bertrik/dotflipper/README.md

# dotflipper
My Flip Dot controller, based on the PCA9865 i2c port expanders

CC BY-SA 4.0
