bertrik/dotflipper/PCB/dotflipperschematic.pdf

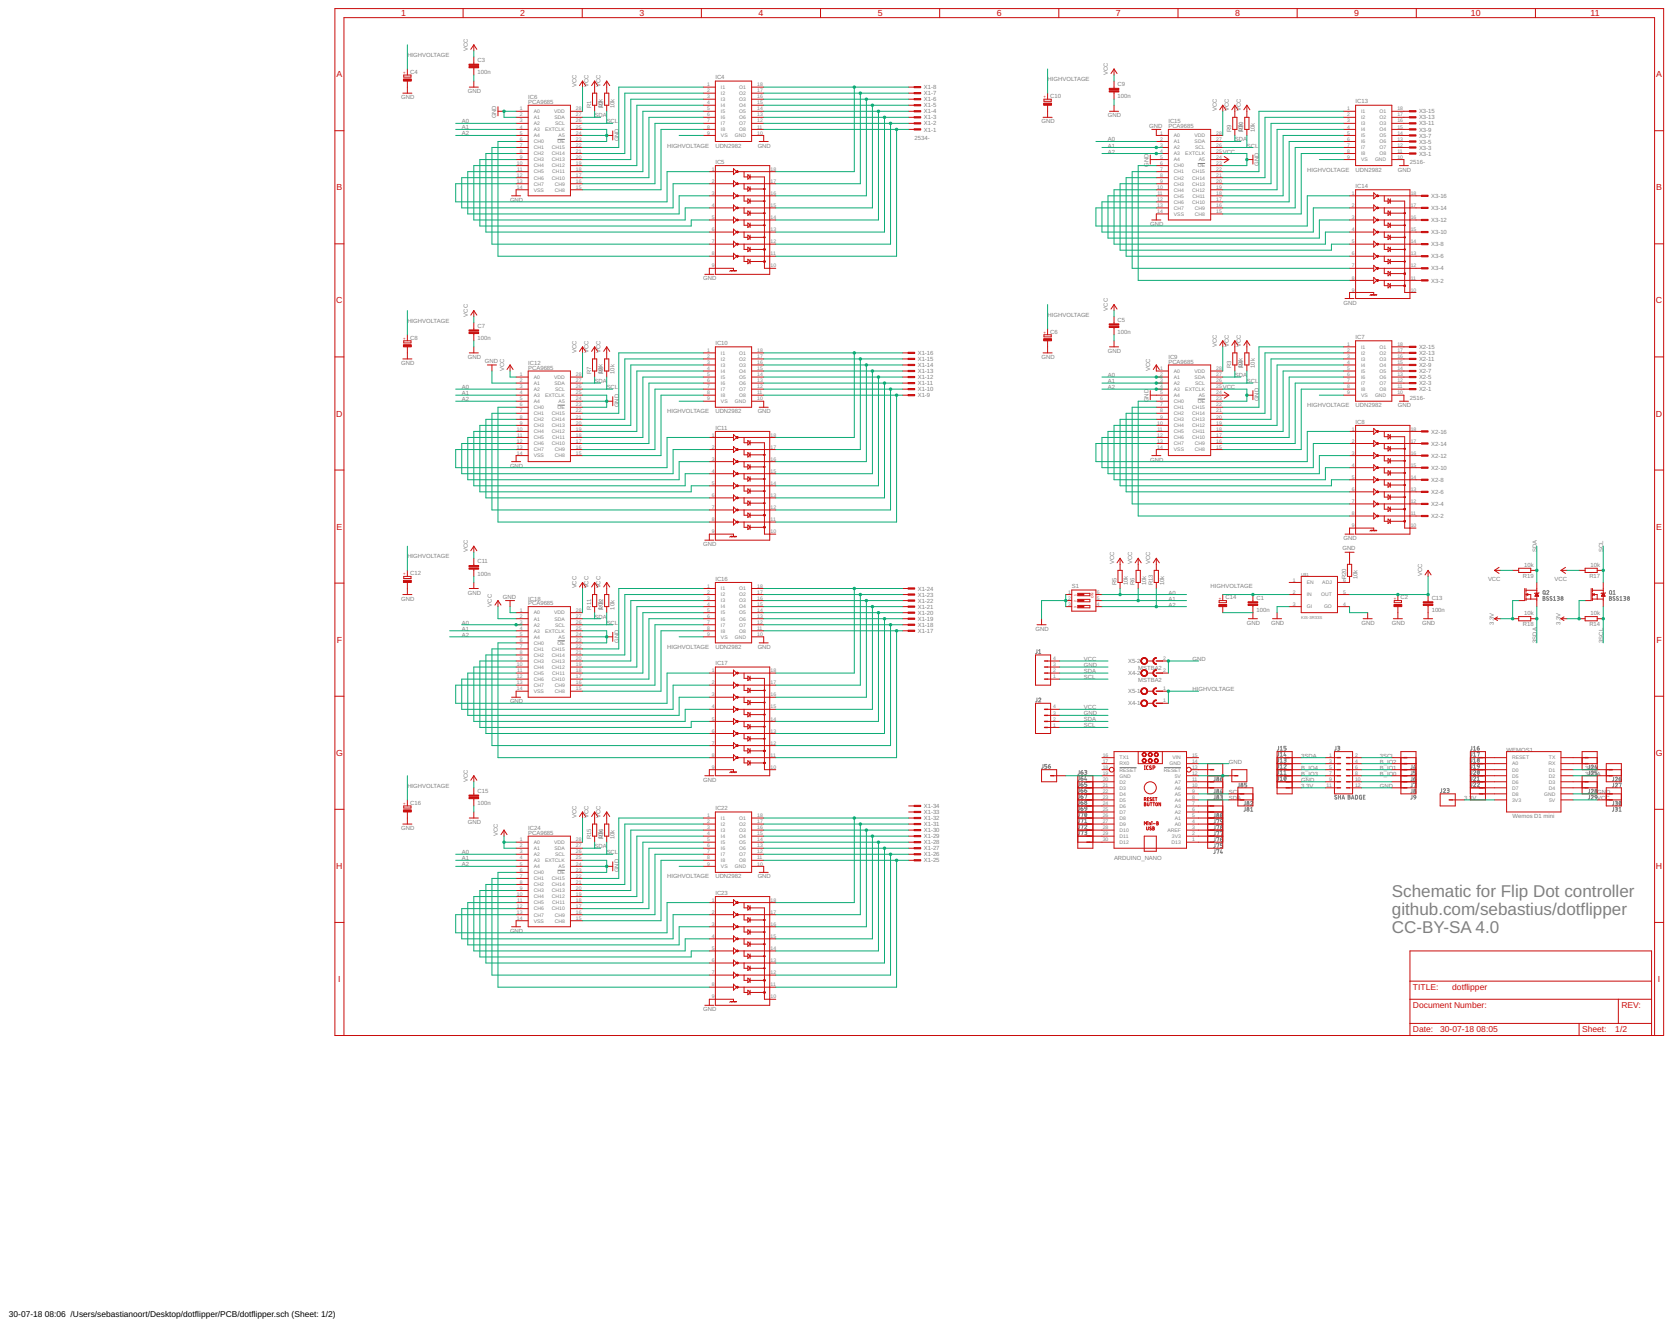
[picture p1: page 1]

CH2 8
CH3 9
CH4 10
CH5 11

Schematic for Flip Dot controller
github.com/sebastius/dotflipper

Document Number: | REV:

Date: 30-07-18 08:05 | Sheet: 1/2

30-07-18 08:06 /Users/sebastianoort/Desktop/dotflipper/PCB/dotflipper.sch (Sheet: 1/2)
