bertrik/dotflipper/PCB/dotflipperboard.pdf

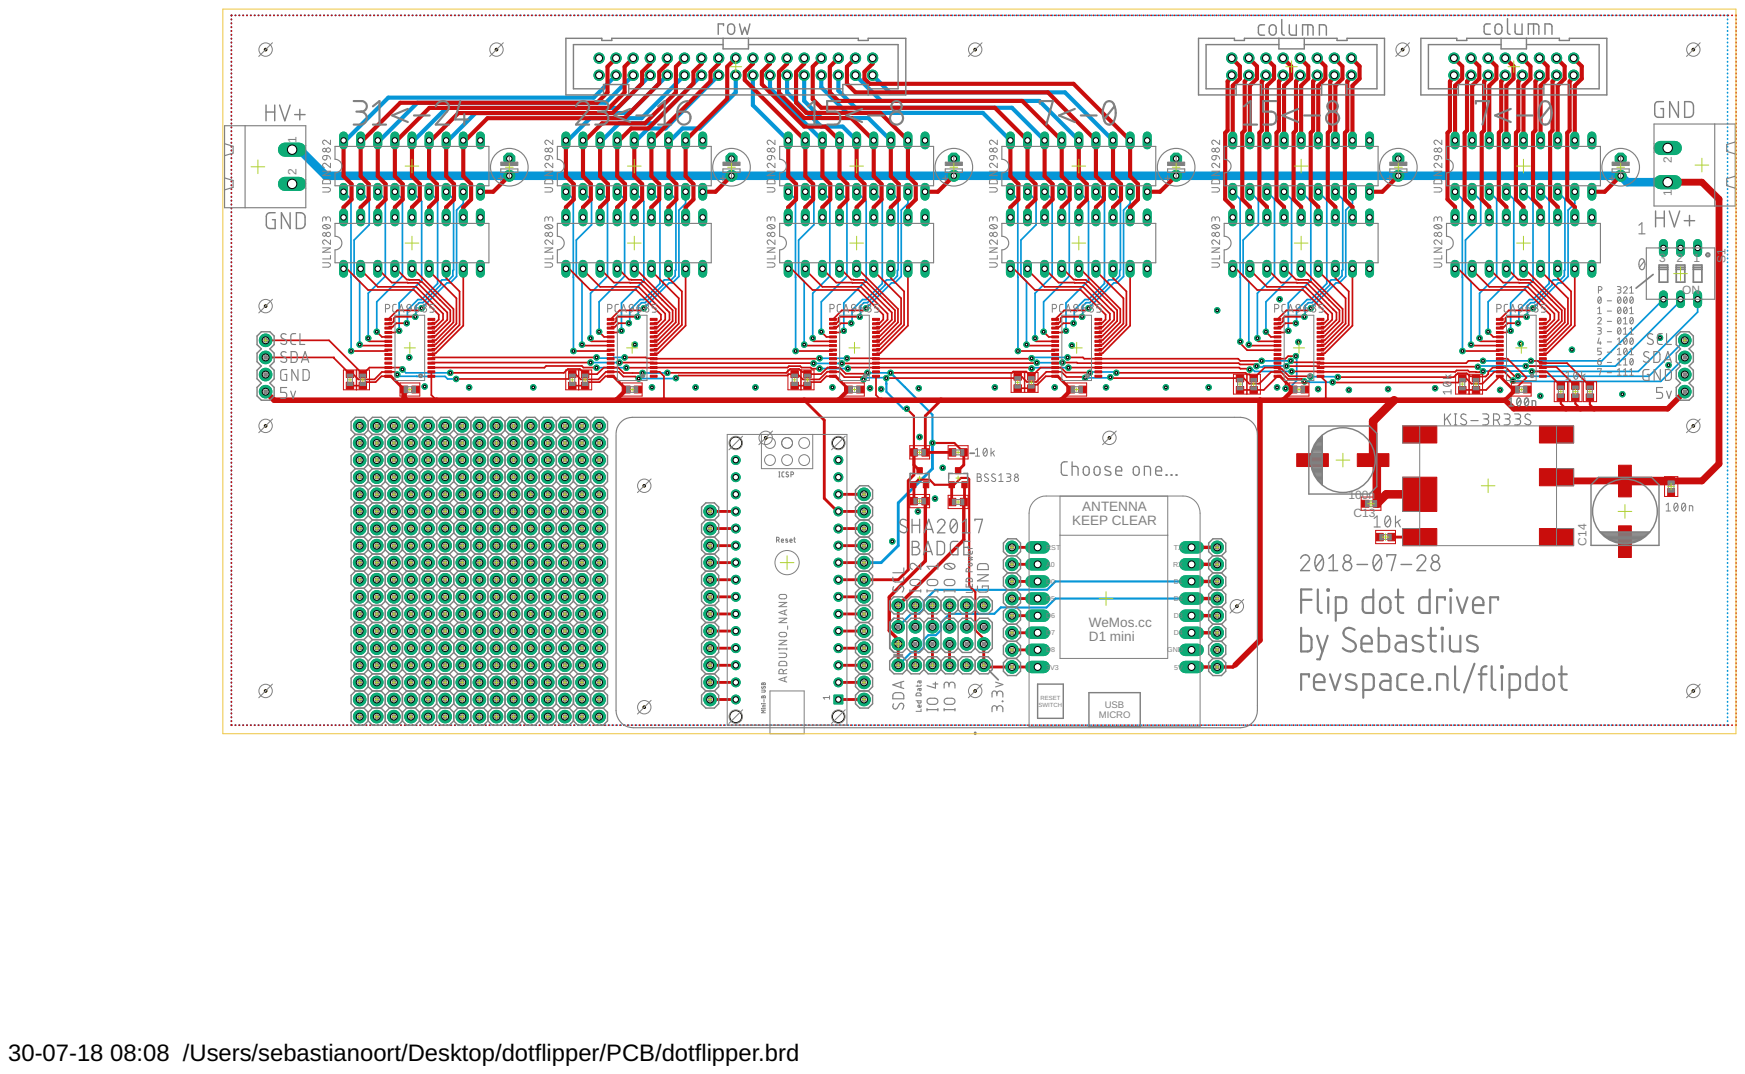
[picture p2: page 1]

30-07-18 08:08 /Users/sebastianoort/Desktop/dotflipper/PCB/dotflipper.brd
