bertrik/dotflipper/PCB/dotflippercomponents.pdf

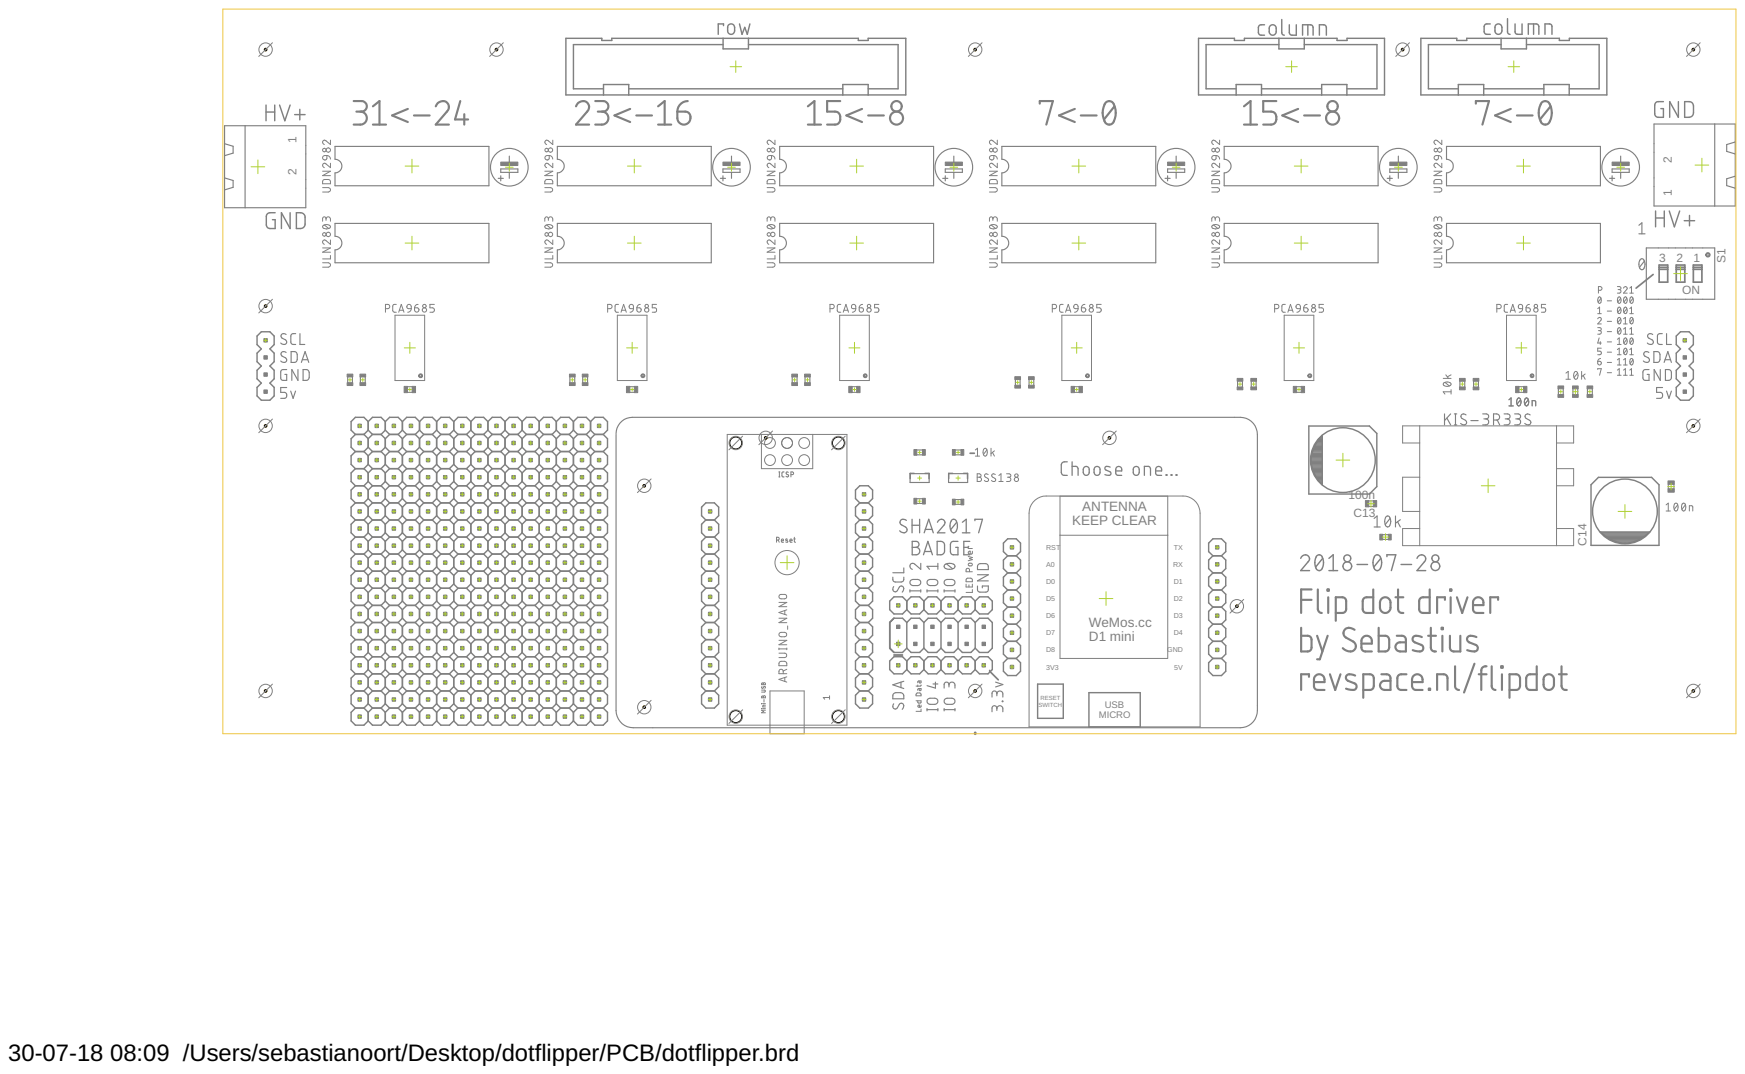
[picture p3: page 1]

30-07-18 08:09 /Users/sebastianoort/Desktop/dotflipper/PCB/dotflipper.brd
