bertrik/dotflipper/PCB/dotflipper.brd

## EAGLE design PCB/dotflipper.brd (2018-07-30)

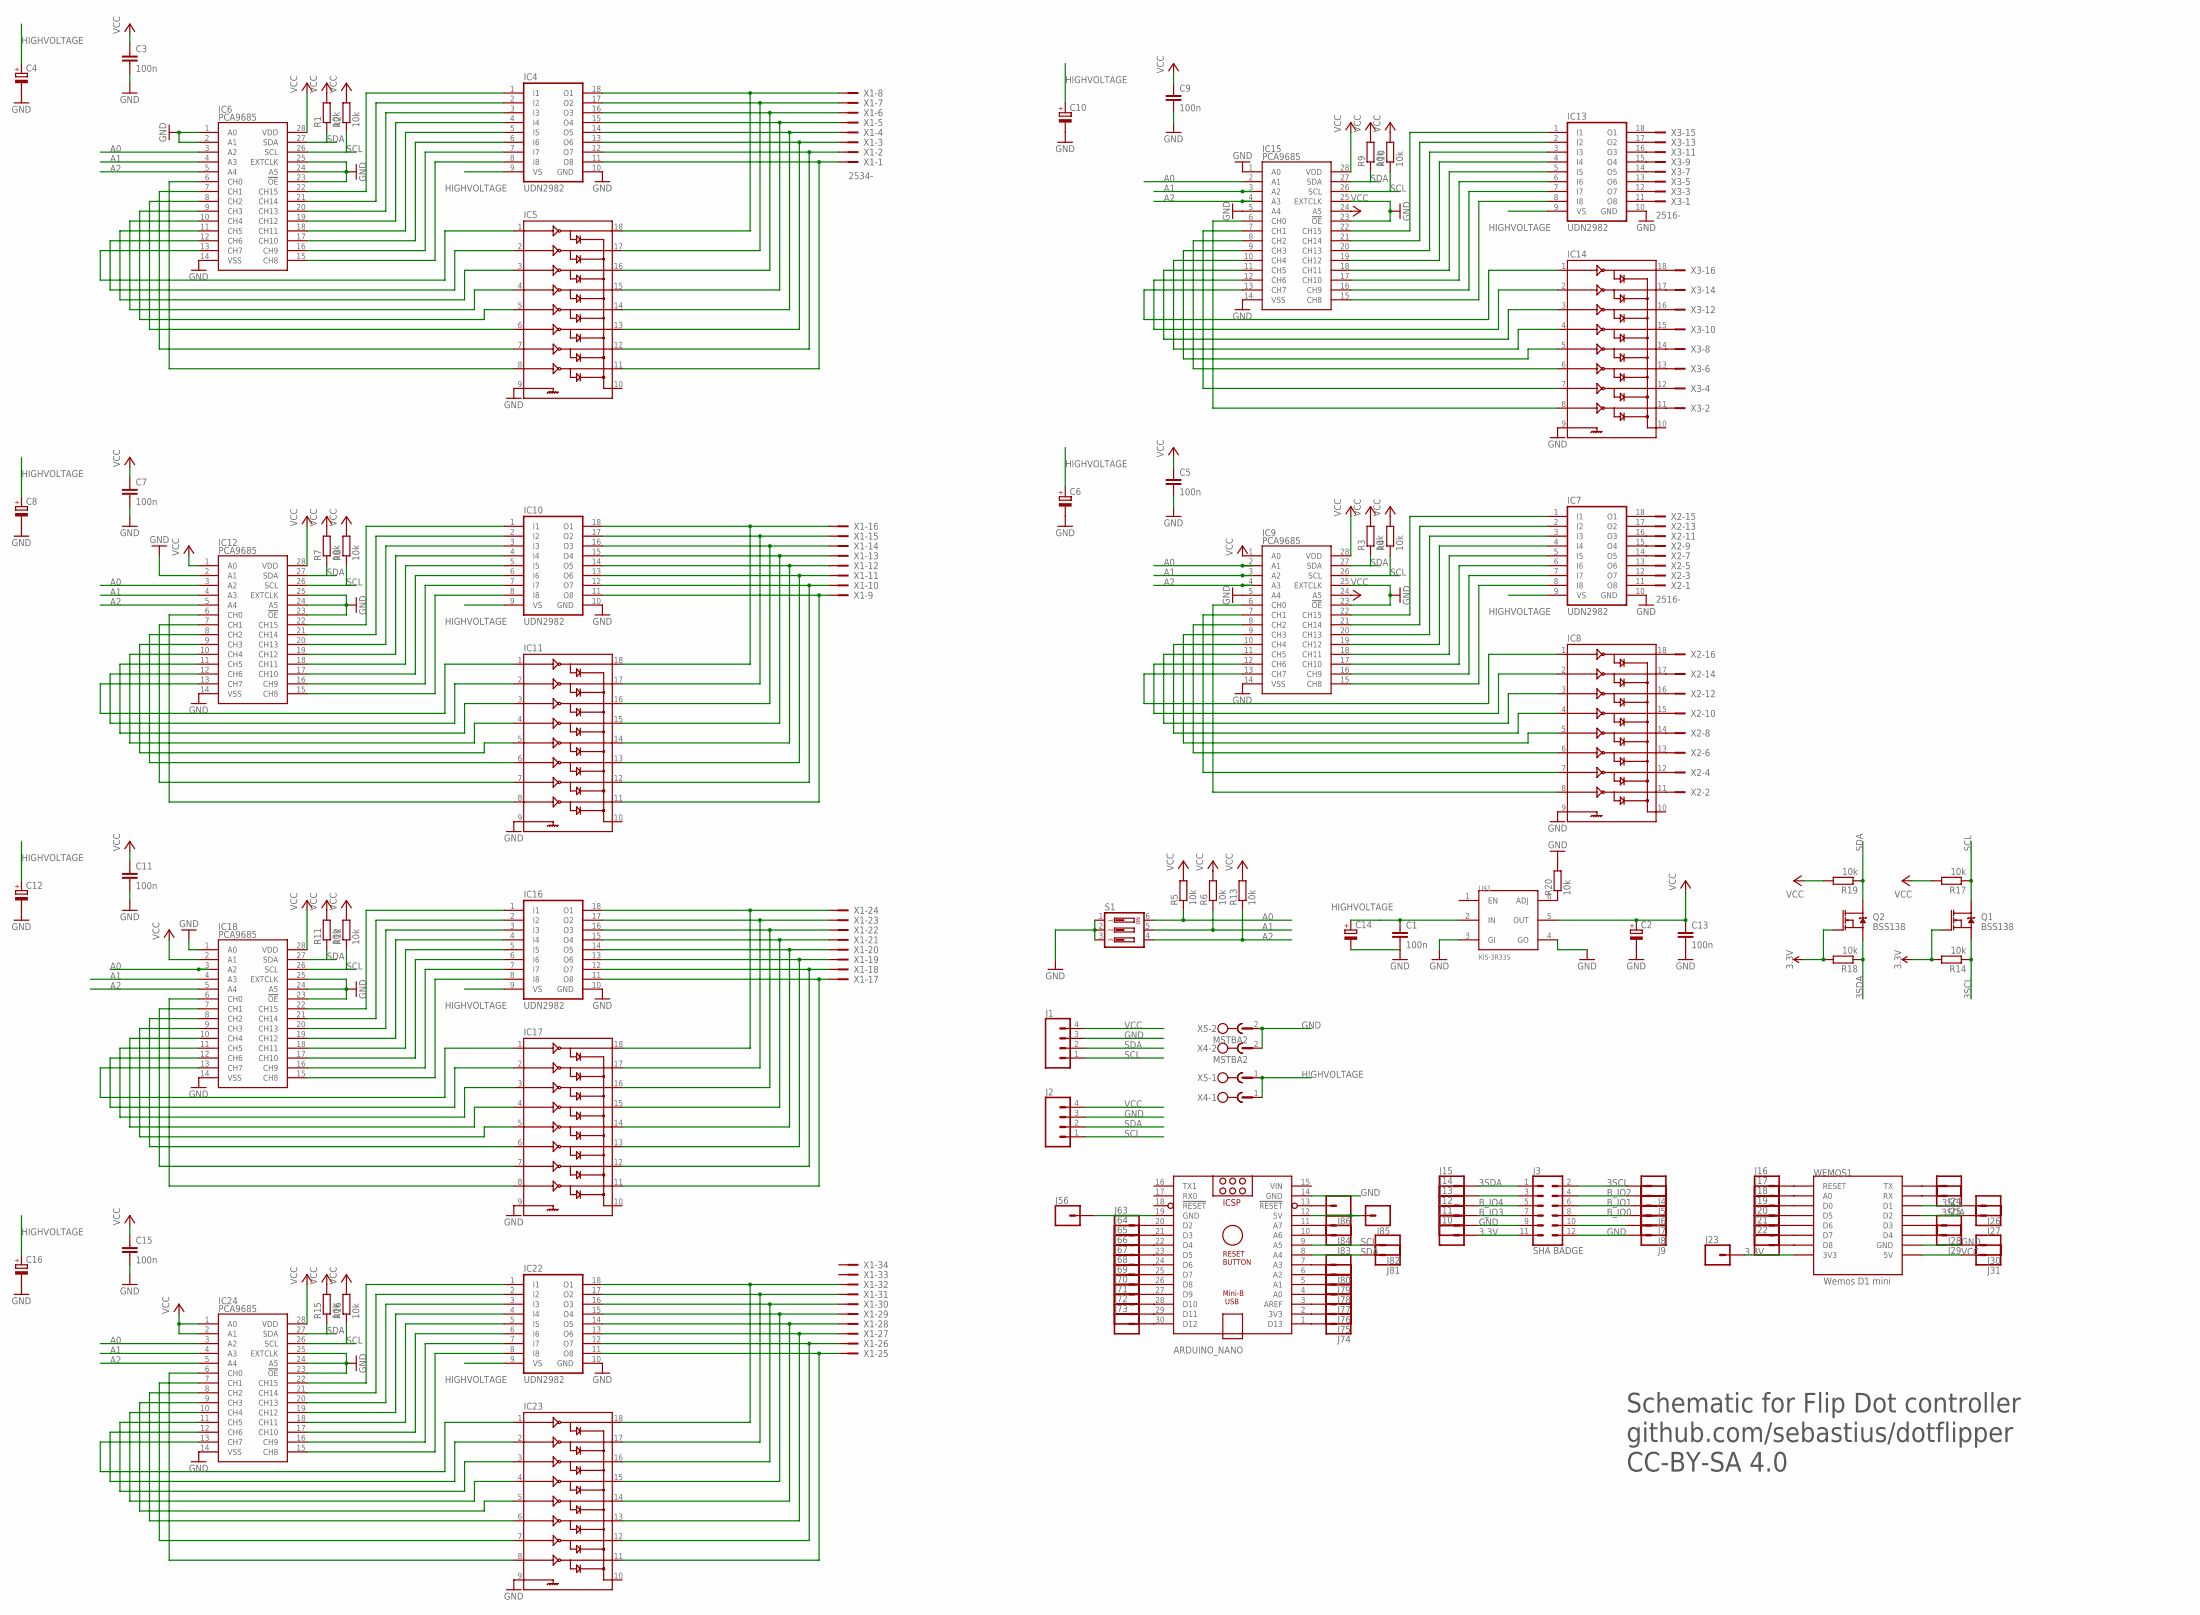
[picture p4: schematic dotflipper.sch, sheet 1]

Parts:
ARDUINO_NANO: ARDUINO_NANO
C1, C3, C5, C7, C9, C11, C13, C15: 100n; C0603
C2, C14: CPOL-EUSANYO_SMD_F8; SANYO-OSCON_SMD_F8
C4, C6, C8, C10, C12, C16: CPOL-EUE2.5-6; E2,5-6
IC4, IC7, IC10, IC13, IC16, IC22: UDN2982; DIL18
IC5, IC8, IC11, IC14, IC17, IC23: ULN2803DIP; DIL18
IC6, IC9, IC12, IC15, IC18, IC24: PCA9685; TSSOP-28_4MM
J1, J2: CONN_04; 1X04
J3: SHA BADGE; 2X6
J4, J5, J6, J7, J8, J9, J10, J11, J12, J13, J14, J15, J16, J17, J18, J19, J20, J21, J22, J23, J24, J25, J26, J27, J28, J29, J30, J31, J56, J63, J64, J65, J66, J67, J68, J69, J70, J71, J72, J73, J74, J75, J76, J77, J78, J79, J80, J81, J82, J83, J84, J85, J86: CONN_01; 1X01
Q1, Q2: BSS138; SOT23-3
R1, R2, R3, R4, R5, R6, R7, R8, R9, R10, R11, R12, R13, R14, R15, R16, R17, R18, R19, R20: 10k; R0603
S1: DIP03YL
U$1: KIS-3R33S
WEMOS1: Wemos D1 mini; WEMOS-D1-MINI
X1: 2534-; PAK100/2500-34
X2, X3: 2516-; PAK100/2500-16
X4, X5: MSTBA2

Connections:
3.3V: J3.11, J10.1, J23.1, Q1.1 (G), Q2.1 (G), R14.2, R18.2, WEMOS1.3V3
3SCL: J3.2, J4.1, J26.1, Q1.2 (S), R14.1, WEMOS1.D1
3SDA: J3.1, J15.1, J27.1, Q2.2 (S), R18.1, WEMOS1.D2
A0: IC6.3 (A2), IC9.2 (A1), IC12.3 (A2), IC15.2 (A1), IC18.3 (A2), IC24.3 (A2), R5.1, S1.6
A1: IC6.4 (A3), IC9.3 (A2), IC12.4 (A3), IC15.3 (A2), IC18.4 (A3), IC24.4 (A3), R6.1, S1.5
A2: IC6.5 (A4), IC9.4 (A3), IC12.5 (A4), IC15.4 (A3), IC18.5 (A4), IC24.5 (A4), R13.1, S1.4
B_IO0: J3.8, J7.1
B_IO1: J3.6, J6.1
B_IO2: J3.4, J5.1
B_IO3: J3.7, J12.1
B_IO4: J3.5, J13.1
GND: ARDUINO_NANO.14 (GND), ARDUINO_NANO.19 (GND), C1.2, C2.-, C3.2, C4.-, C5.2, C6.-, C7.2, C8.-, C9.2, C10.-, C11.2, C12.-, C13.2, C14.-, C15.2, C16.-, IC4.10 (GND), IC5.9, IC6.1 (A0), IC6.2 (A1), IC6.14 (VSS), IC6.23 (!OE), IC6.24 (A5), IC6.25 (EXTCLK), IC7.10 (GND), IC8.9, IC9.5 (A4), IC9.14 (VSS), IC9.23 (!OE), IC9.25 (EXTCLK), IC10.10 (GND), IC11.9, IC12.2 (A1), IC12.14 (VSS), IC12.23 (!OE), IC12.24 (A5), IC12.25 (EXTCLK), IC13.10 (GND), IC14.9, IC15.1 (A0), IC15.5 (A4), IC15.14 (VSS), IC15.23 (!OE), IC15.25 (EXTCLK), IC16.10 (GND), IC17.9, IC18.1 (A0), IC18.14 (VSS), IC18.23 (!OE), IC18.24 (A5), IC18.25 (EXTCLK), IC22.10 (GND), IC23.9, IC24.14 (VSS), IC24.23 (!OE), IC24.24 (A5), IC24.25 (EXTCLK), J1.3, J2.3, J3.9, J3.12, J9.1, J11.1, J30.1, J56.1, R20.2, S1.1, S1.2, S1.3, U$1.3 (GI), U$1.4 (GO), WEMOS1.GND, X4.2, X5.2
HIGHVOLTAGE: C1.1, C4.+, C6.+, C8.+, C10.+, C12.+, C14.+, C16.+, IC4.9 (VS), IC7.9 (VS), IC10.9 (VS), IC13.9 (VS), IC16.9 (VS), IC22.9 (VS), U$1.2 (IN), X4.1, X5.1
unnamed: IC4.1 (I1), IC6.22 (CH15)
unnamed: IC4.2 (I2), IC6.21 (CH14)
unnamed: IC4.3 (I3), IC6.20 (CH13)
unnamed: IC4.4 (I4), IC6.19 (CH12)
unnamed: IC7.11 (O8), X2.1
unnamed: IC4.5 (I5), IC6.18 (CH11)
unnamed: IC8.11, X2.2
unnamed: IC7.12 (O7), X2.3
unnamed: IC8.12, X2.4
unnamed: IC7.13 (O6), X2.5
unnamed: IC7.14 (O5), X2.7
unnamed: IC7.15 (O4), X2.9
unnamed: IC7.16 (O3), X2.11
unnamed: IC7.17 (O2), X2.13
unnamed: IC7.18 (O1), X2.15
unnamed: IC8.13, X2.6
unnamed: IC4.6 (I6), IC6.17 (CH10)
unnamed: IC4.7 (I7), IC6.16 (CH9)
unnamed: IC8.14, X2.8
unnamed: IC4.8 (I8), IC6.15 (CH8)
unnamed: IC5.4, IC6.10 (CH4)
unnamed: IC8.15, X2.10
unnamed: IC8.16, X2.12
unnamed: IC8.17, X2.14
unnamed: IC5.6, IC6.8 (CH2)
unnamed: IC5.7, IC6.7 (CH1)
unnamed: IC8.18, X2.16
unnamed: IC5.8, IC6.6 (CH0)
unnamed: IC5.2, IC6.12 (CH6)
unnamed: IC5.3, IC6.11 (CH5)
unnamed: IC5.5, IC6.9 (CH3)
unnamed: IC5.1, IC6.13 (CH7)
unnamed: IC13.11 (O8), X3.1
unnamed: IC4.12 (O7), IC5.12, X1.2
unnamed: IC13.12 (O7), X3.3
unnamed: IC4.14 (O5), IC5.14, X1.4
unnamed: IC13.13 (O6), X3.5
unnamed: IC4.16 (O3), IC5.16, X1.6
unnamed: IC13.14 (O5), X3.7
unnamed: IC13.15 (O4), X3.9
unnamed: IC4.18 (O1), IC5.18, X1.8
unnamed: IC13.16 (O3), X3.11
unnamed: IC4.11 (O8), IC5.11, X1.1
unnamed: IC13.17 (O2), X3.13
unnamed: IC4.13 (O6), IC5.13, X1.3
unnamed: IC13.18 (O1), X3.15
unnamed: IC4.15 (O4), IC5.15, X1.5
unnamed: IC4.17 (O2), IC5.17, X1.7
unnamed: IC7.1 (I1), IC9.22 (CH15)
unnamed: IC7.2 (I2), IC9.21 (CH14)
unnamed: IC7.3 (I3), IC9.20 (CH13)
unnamed: IC7.4 (I4), IC9.19 (CH12)
unnamed: IC7.5 (I5), IC9.18 (CH11)
unnamed: IC7.6 (I6), IC9.17 (CH10)
unnamed: IC7.7 (I7), IC9.16 (CH9)
unnamed: IC7.8 (I8), IC9.15 (CH8)
unnamed: IC8.4, IC9.10 (CH4)
unnamed: IC8.6, IC9.8 (CH2)
unnamed: IC8.7, IC9.7 (CH1)
unnamed: IC8.8, IC9.6 (CH0)
unnamed: IC8.2, IC9.12 (CH6)
unnamed: IC8.3, IC9.11 (CH5)
unnamed: IC8.5, IC9.9 (CH3)
unnamed: IC8.1, IC9.13 (CH7)
unnamed: IC14.11, X3.2
unnamed: IC14.12, X3.4
unnamed: IC14.13, X3.6
unnamed: IC14.14, X3.8
unnamed: IC14.15, X3.10
unnamed: IC14.16, X3.12
unnamed: IC14.17, X3.14
unnamed: IC14.18, X3.16
unnamed: IC10.1 (I1), IC12.22 (CH15)
unnamed: IC10.2 (I2), IC12.21 (CH14)
unnamed: IC10.3 (I3), IC12.20 (CH13)
unnamed: IC10.4 (I4), IC12.19 (CH12)
unnamed: IC10.5 (I5), IC12.18 (CH11)
unnamed: IC10.6 (I6), IC12.17 (CH10)
unnamed: IC10.7 (I7), IC12.16 (CH9)
unnamed: IC10.8 (I8), IC12.15 (CH8)
unnamed: IC11.4, IC12.10 (CH4)
unnamed: IC11.6, IC12.8 (CH2)
unnamed: IC11.7, IC12.7 (CH1)
unnamed: IC11.8, IC12.6 (CH0)
unnamed: IC11.2, IC12.12 (CH6)
unnamed: IC11.3, IC12.11 (CH5)
unnamed: IC11.5, IC12.9 (CH3)
unnamed: IC11.1, IC12.13 (CH7)
unnamed: IC10.12 (O7), IC11.12, X1.10
unnamed: IC10.14 (O5), IC11.14, X1.12
unnamed: IC10.16 (O3), IC11.16, X1.14
unnamed: IC10.18 (O1), IC11.18, X1.16
unnamed: IC10.11 (O8), IC11.11, X1.9
unnamed: IC10.13 (O6), IC11.13, X1.11
unnamed: IC10.15 (O4), IC11.15, X1.13
unnamed: IC10.17 (O2), IC11.17, X1.15
unnamed: J16.1, WEMOS1.RESET
unnamed: J17.1, WEMOS1.A0
unnamed: J3.3, J14.1
unnamed: R20.1, U$1.6 (ADJ)
unnamed: J18.1, WEMOS1.D0
unnamed: J19.1, WEMOS1.D5
unnamed: J20.1, WEMOS1.D6
unnamed: J21.1, WEMOS1.D7
unnamed: IC13.1 (I1), IC15.22 (CH15)
unnamed: IC13.2 (I2), IC15.21 (CH14)
unnamed: IC13.3 (I3), IC15.20 (CH13)
unnamed: IC13.4 (I4), IC15.19 (CH12)
unnamed: IC13.5 (I5), IC15.18 (CH11)
unnamed: IC13.6 (I6), IC15.17 (CH10)
unnamed: IC13.7 (I7), IC15.16 (CH9)
unnamed: IC13.8 (I8), IC15.15 (CH8)
unnamed: IC14.4, IC15.10 (CH4)
unnamed: IC14.6, IC15.8 (CH2)
unnamed: IC14.7, IC15.7 (CH1)
unnamed: IC14.8, IC15.6 (CH0)
unnamed: IC14.2, IC15.12 (CH6)
unnamed: IC14.3, IC15.11 (CH5)
unnamed: IC14.5, IC15.9 (CH3)
unnamed: IC14.1, IC15.13 (CH7)
unnamed: IC16.1 (I1), IC18.22 (CH15)
unnamed: IC16.2 (I2), IC18.21 (CH14)
unnamed: IC16.3 (I3), IC18.20 (CH13)
unnamed: IC16.4 (I4), IC18.19 (CH12)
unnamed: IC16.5 (I5), IC18.18 (CH11)
unnamed: IC16.6 (I6), IC18.17 (CH10)
unnamed: IC16.7 (I7), IC18.16 (CH9)
unnamed: IC16.8 (I8), IC18.15 (CH8)
unnamed: IC17.4, IC18.10 (CH4)
unnamed: IC17.6, IC18.8 (CH2)
unnamed: IC17.7, IC18.7 (CH1)
unnamed: IC17.8, IC18.6 (CH0)
unnamed: IC17.2, IC18.12 (CH6)
unnamed: IC17.3, IC18.11 (CH5)
unnamed: IC17.5, IC18.9 (CH3)
unnamed: IC17.1, IC18.13 (CH7)
unnamed: IC16.12 (O7), IC17.12, X1.18
unnamed: IC16.14 (O5), IC17.14, X1.20
unnamed: IC16.16 (O3), IC17.16, X1.22
unnamed: IC16.18 (O1), IC17.18, X1.24
unnamed: IC16.11 (O8), IC17.11, X1.17
unnamed: IC16.13 (O6), IC17.13, X1.19
unnamed: IC16.15 (O4), IC17.15, X1.21
unnamed: IC16.17 (O2), IC17.17, X1.23
unnamed: J22.1, WEMOS1.D8
unnamed: J24.1, WEMOS1.TX
unnamed: J3.10, J8.1
unnamed: J25.1, WEMOS1.RX
unnamed: J28.1, WEMOS1.D3
unnamed: J29.1, WEMOS1.D4
unnamed: ARDUINO_NANO.20 (D2), J63.1
unnamed: ARDUINO_NANO.21 (D3), J64.1
unnamed: ARDUINO_NANO.22 (D4), J65.1
unnamed: ARDUINO_NANO.23 (D5), J66.1
unnamed: ARDUINO_NANO.24 (D6), J67.1
unnamed: ARDUINO_NANO.25 (D7), J68.1
unnamed: ARDUINO_NANO.26 (D8), J69.1
unnamed: ARDUINO_NANO.27 (D9), J70.1
unnamed: ARDUINO_NANO.28 (D10), J71.1
unnamed: ARDUINO_NANO.29 (D11), J72.1
unnamed: ARDUINO_NANO.30 (D12), J73.1
unnamed: ARDUINO_NANO.1 (D13), J74.1
unnamed: ARDUINO_NANO.2 (3V3), J75.1
unnamed: ARDUINO_NANO.3 (AREF), J76.1
unnamed: ARDUINO_NANO.4 (A0), J77.1
unnamed: ARDUINO_NANO.5 (A1), J78.1
unnamed: ARDUINO_NANO.6 (A2), J79.1
unnamed: IC22.1 (I1), IC24.22 (CH15)
unnamed: IC22.2 (I2), IC24.21 (CH14)
unnamed: IC22.3 (I3), IC24.20 (CH13)
unnamed: IC22.4 (I4), IC24.19 (CH12)
unnamed: IC22.5 (I5), IC24.18 (CH11)
unnamed: IC22.6 (I6), IC24.17 (CH10)
unnamed: IC22.7 (I7), IC24.16 (CH9)
unnamed: IC22.8 (I8), IC24.15 (CH8)
unnamed: IC23.4, IC24.10 (CH4)
unnamed: IC23.6, IC24.8 (CH2)
unnamed: IC23.7, IC24.7 (CH1)
unnamed: IC23.8, IC24.6 (CH0)
unnamed: IC23.2, IC24.12 (CH6)
unnamed: IC23.3, IC24.11 (CH5)
unnamed: IC23.5, IC24.9 (CH3)
unnamed: IC23.1, IC24.13 (CH7)
unnamed: IC22.12 (O7), IC23.12, X1.26
unnamed: IC22.14 (O5), IC23.14, X1.28
unnamed: IC22.16 (O3), IC23.16, X1.30
unnamed: IC22.18 (O1), IC23.18, X1.32
unnamed: IC22.11 (O8), IC23.11, X1.25
unnamed: IC22.13 (O6), IC23.13, X1.27
unnamed: IC22.15 (O4), IC23.15, X1.29
unnamed: IC22.17 (O2), IC23.17, X1.31
unnamed: ARDUINO_NANO.7 (A3), J80.1
unnamed: ARDUINO_NANO.10 (A6), J83.1
unnamed: ARDUINO_NANO.11 (A7), J84.1
unnamed: ARDUINO_NANO.13 (!RESET), J86.1
SCL: ARDUINO_NANO.9 (A5), IC6.26 (SCL), IC9.26 (SCL), IC12.26 (SCL), IC15.26 (SCL), IC18.26 (SCL), IC24.26 (SCL), J1.1, J2.1, J82.1, Q1.3 (D), R2.1, R4.1, R8.1, R10.1, R12.1, R16.1, R17.1
SDA: ARDUINO_NANO.8 (A4), IC6.27 (SDA), IC9.27 (SDA), IC12.27 (SDA), IC15.27 (SDA), IC18.27 (SDA), IC24.27 (SDA), J1.2, J2.2, J81.1, Q2.3 (D), R1.1, R3.1, R7.1, R9.1, R11.1, R15.1, R19.1
VCC: ARDUINO_NANO.12 (5V), C2.+, C3.1, C5.1, C7.1, C9.1, C11.1, C13.1, C15.1, IC6.28 (VDD), IC9.1 (A0), IC9.24 (A5), IC9.28 (VDD), IC12.1 (A0), IC12.28 (VDD), IC15.24 (A5), IC15.28 (VDD), IC18.2 (A1), IC18.28 (VDD), IC24.1 (A0), IC24.2 (A1), IC24.28 (VDD), J1.4, J2.4, J31.1, J85.1, R1.2, R2.2, R3.2, R4.2, R5.2, R6.2, R7.2, R8.2, R9.2, R10.2, R11.2, R12.2, R13.2, R15.2, R16.2, R17.2, R19.2, U$1.5 (OUT), WEMOS1.5V
VIN: ARDUINO_NANO.15 (VIN)

Notes on the sheet:
Schematic for Flip Dot controller github.com/sebastius/dotflipper CC-BY-SA 4.0

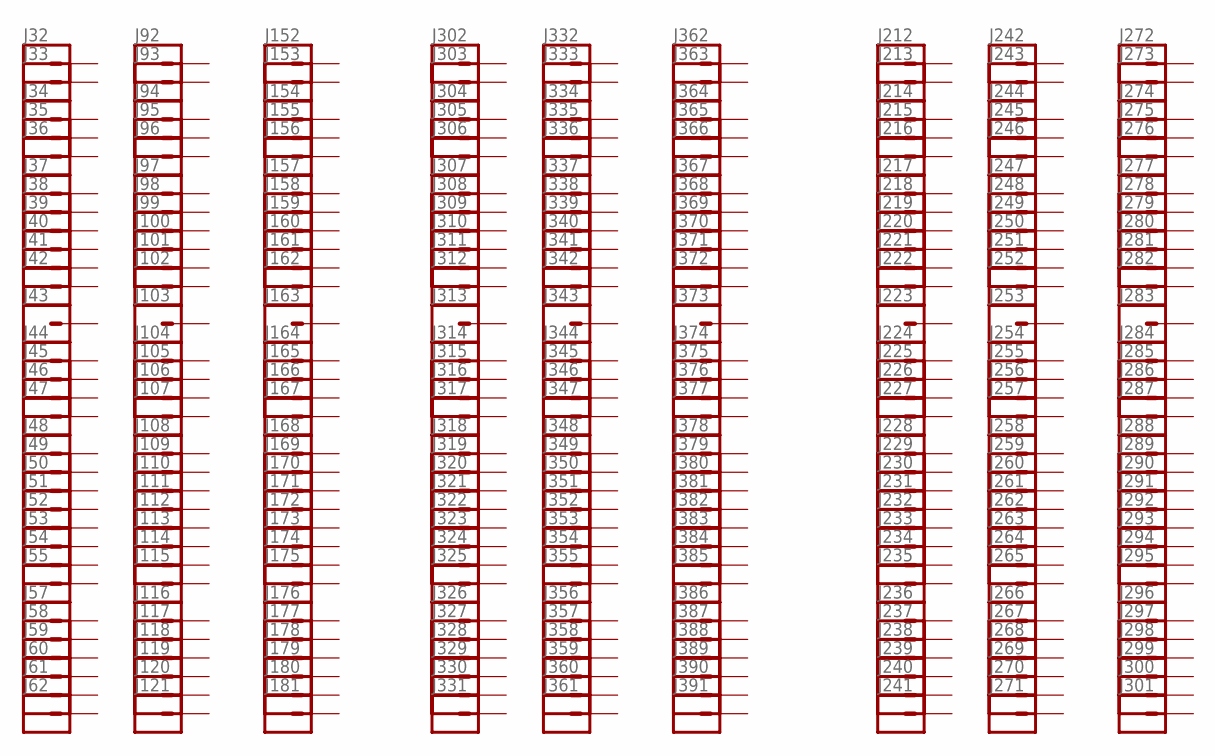
[picture p5: schematic dotflipper.sch, sheet 2]

Parts:
J32, J33, J34, J35, J36, J37, J38, J39, J40, J41, J42, J43, J44, J45, J46, J47, J48, J49, J50, J51, J52, J53, J54, J55, J57, J58, J59, J60, J61, J62, J92, J93, J94, J95, J96, J97, J98, J99, J100, J101, J102, J103, J104, J105, J106, J107, J108, J109, J110, J111, J112, J113, J114, J115, J116, J117, J118, J119, J120, J121, J152, J153, J154, J155, J156, J157, J158, J159, J160, J161, J162, J163, J164, J165, J166, J167, J168, J169, J170, J171, J172, J173, J174, J175, J176, J177, J178, J179, J180, J181, J212, J213, J214, J215, J216, J217, J218, J219, J220, J221, J222, J223, J224, J225, J226, J227, J228, J229, J230, J231, J232, J233, J234, J235, J236, J237, J238, J239, J240, J241, J242, J243, J244, J245, J246, J247, J248, J249, J250, J251, J252, J253, J254, J255, J256, J257, J258, J259, J260, J261, J262, J263, J264, J265, J266, J267, J268, J269, J270, J271, J272, J273, J274, J275, J276, J277, J278, J279, J280, J281, J282, J283, J284, J285, J286, J287, J288, J289, J290, J291, J292, J293, J294, J295, J296, J297, J298, J299, J300, J301, J302, J303, J304, J305, J306, J307, J308, J309, J310, J311, J312, J313, J314, J315, J316, J317, J318, J319, J320, J321, J322, J323, J324, J325, J326, J327, J328, J329, J330, J331, J332, J333, J334, J335, J336, J337, J338, J339, J340, J341, J342, J343, J344, J345, J346, J347, J348, J349, J350, J351, J352, J353, J354, J355, J356, J357, J358, J359, J360, J361, J362, J363, J364, J365, J366, J367, J368, J369, J370, J371, J372, J373, J374, J375, J376, J377, J378, J379, J380, J381, J382, J383, J384, J385, J386, J387, J388, J389, J390, J391: CONN_01; 1X01

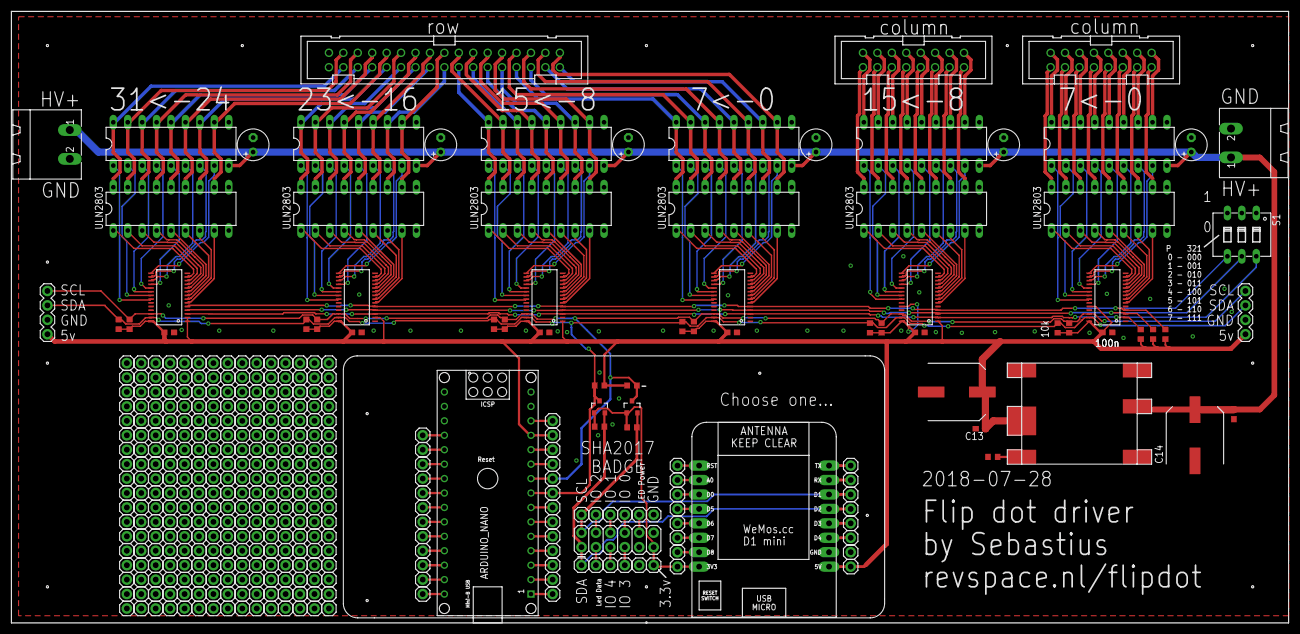
[picture p6: board dotflipper.brd from above]

Board: 2 copper layers, 224.8 x 107.6 mm, 391 parts (0 on the bottom side), 211 nets.
