bertrik/dotflipper/(commit log)

2018-07-29 First public release
    [dotflipper.brd, dotflipper.sch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]
2018-07-30 Readability and more explanation of how to flip a bit based on boolean color
    [esp_flipdot.ino]
2018-07-30 Minor cleanup of schematic. Made PDFs for those without Eagle.
    [dotflipper.brd, dotflipper.sch]
2018-08-08 More nitpicking to improve readabilty and prevent stupid errors
    [esp_flipdot.ino]
2018-08-11 updated safety in void flipdot()
    [esp_flipdot.ino]
2018-09-02 twee variabelen die niet gebruikt werden weg. Verplaatsen uitlezen joystick naar eigen void. Nog niet af.
